NStevenU/MBP-15-A1398-Speaker-Mod/Enclosure/R2.stl

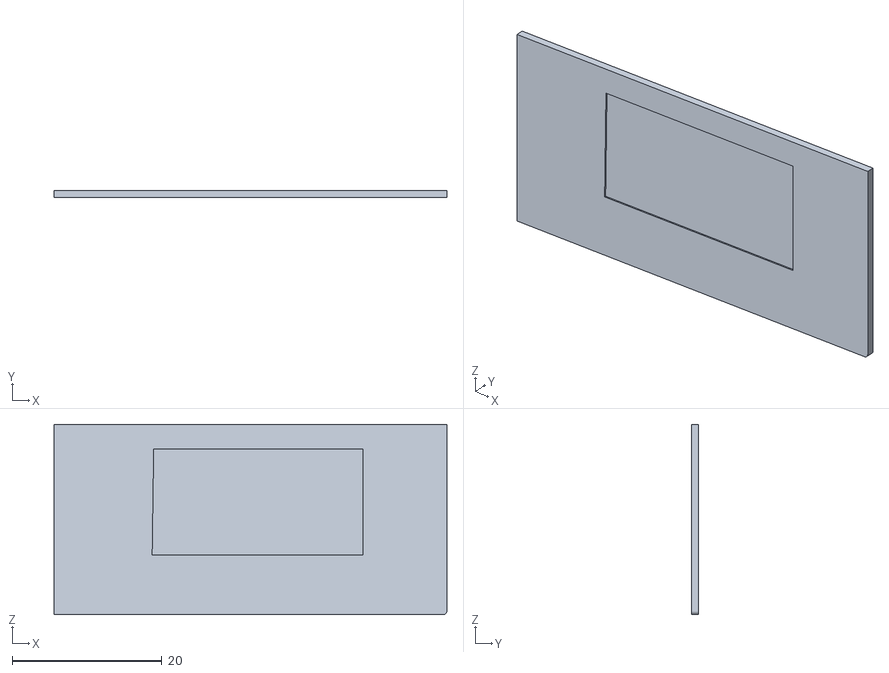
[picture p11: CAD file, 2026-10-30]
Enclosure/R2.stl
52.5 x 1.00 x 25.4
