NStevenU/MBP-15-A1398-Speaker-Mod/Enclosure/R3.stl

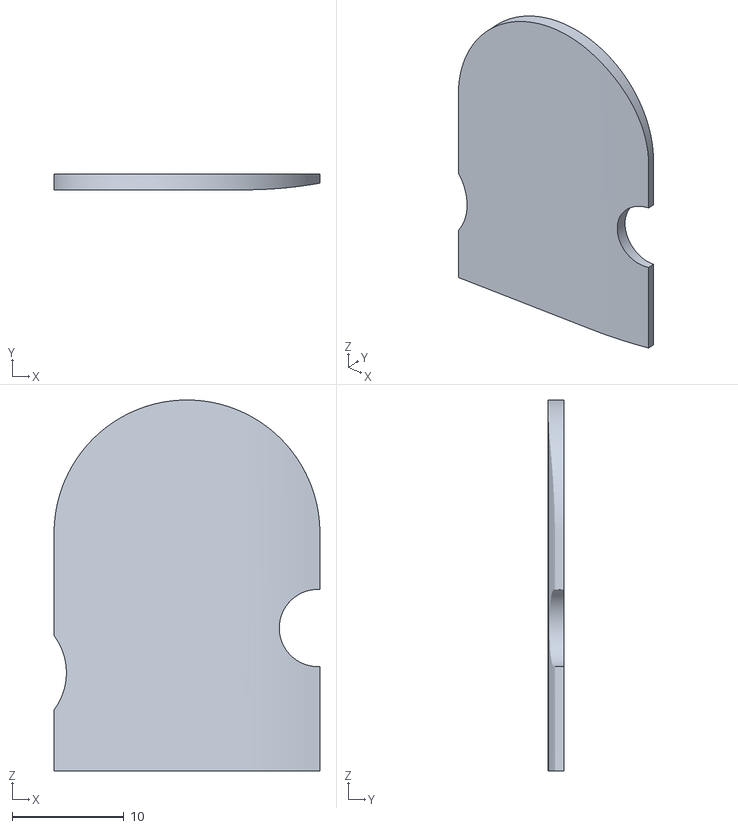
[picture p12: CAD file, 2026-10-30]
Enclosure/R3.stl
23.8 x 1.40 x 33.2
