NStevenU/MBP-15-A1398-Speaker-Mod/Enclosure/Enclosure.step

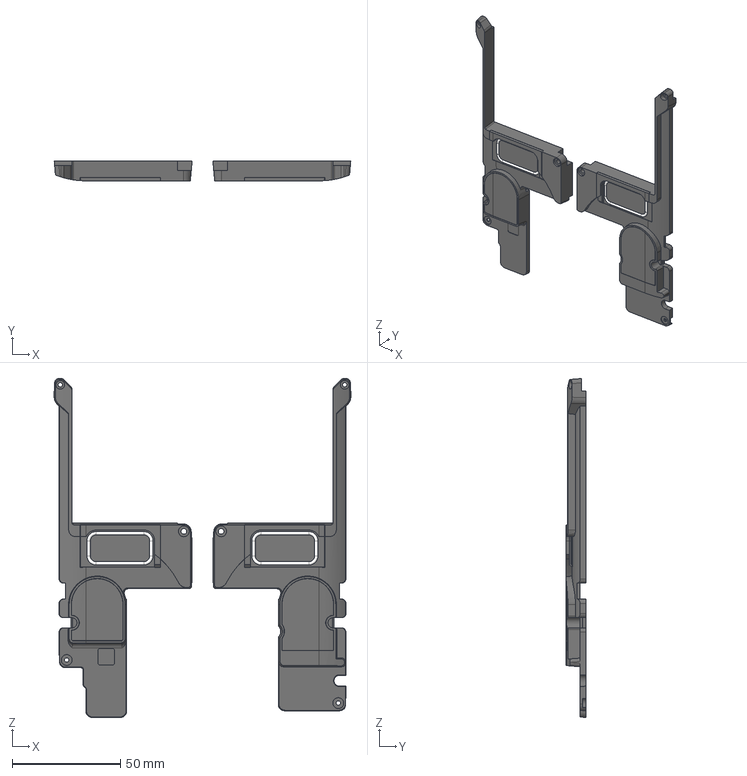
[picture p13: CAD file, 2026-10-30]
Enclosure/Enclosure.step
137.0 x 9.10 x 156.6 mm
Right
Left
