NStevenU/MBP-15-A1398-Speaker-Mod/Enclosure/L4.stl

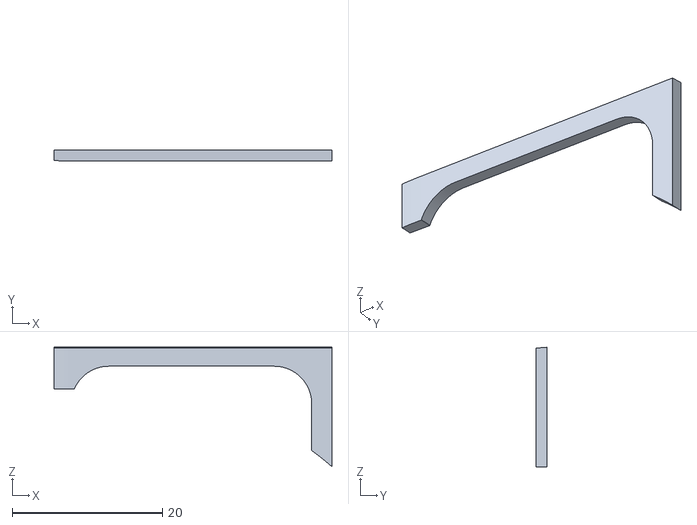
[picture p14: CAD file, 2026-10-30]
Enclosure/L4.stl
37.0 x 1.50 x 15.9
