NStevenU/MBP-15-A1398-Speaker-Mod/Enclosure/R1.stl

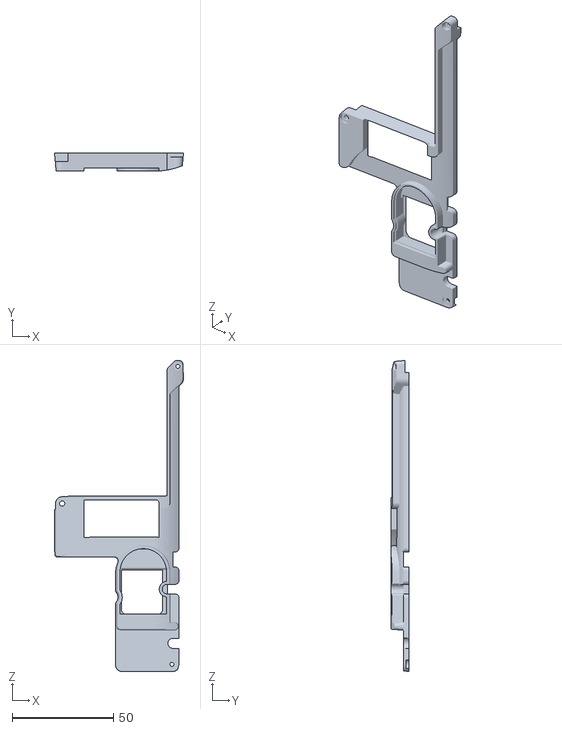
[picture p15: CAD file, 2026-10-30]
Enclosure/R1.stl
63.7 x 9.10 x 153.5
