NStevenU/MBP-15-A1398-Speaker-Mod/Enclosure/L1.stl

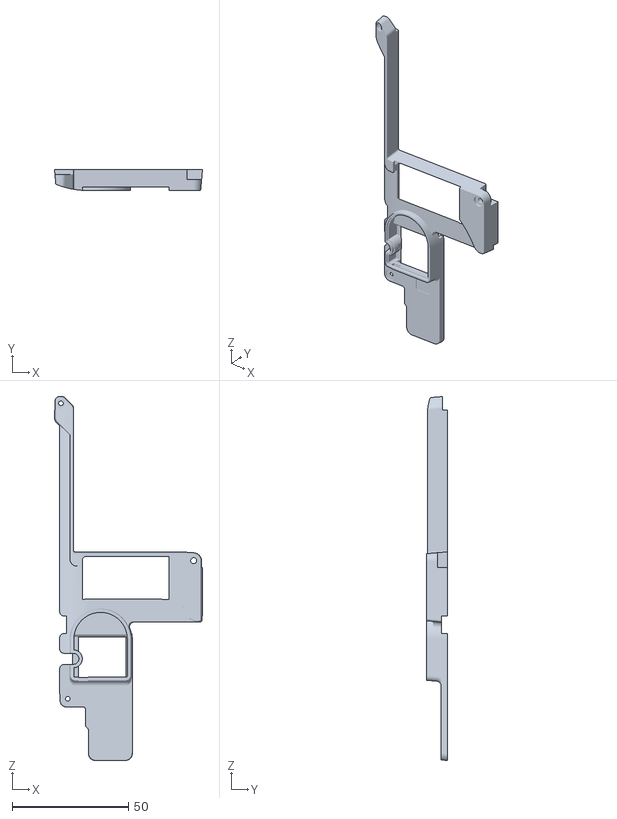
[picture p16: CAD file, 2026-10-30]
Enclosure/L1.stl
63.7 x 9.10 x 156.6
