NStevenU/MBP-15-A1398-Speaker-Mod/Enclosure/L3.stl

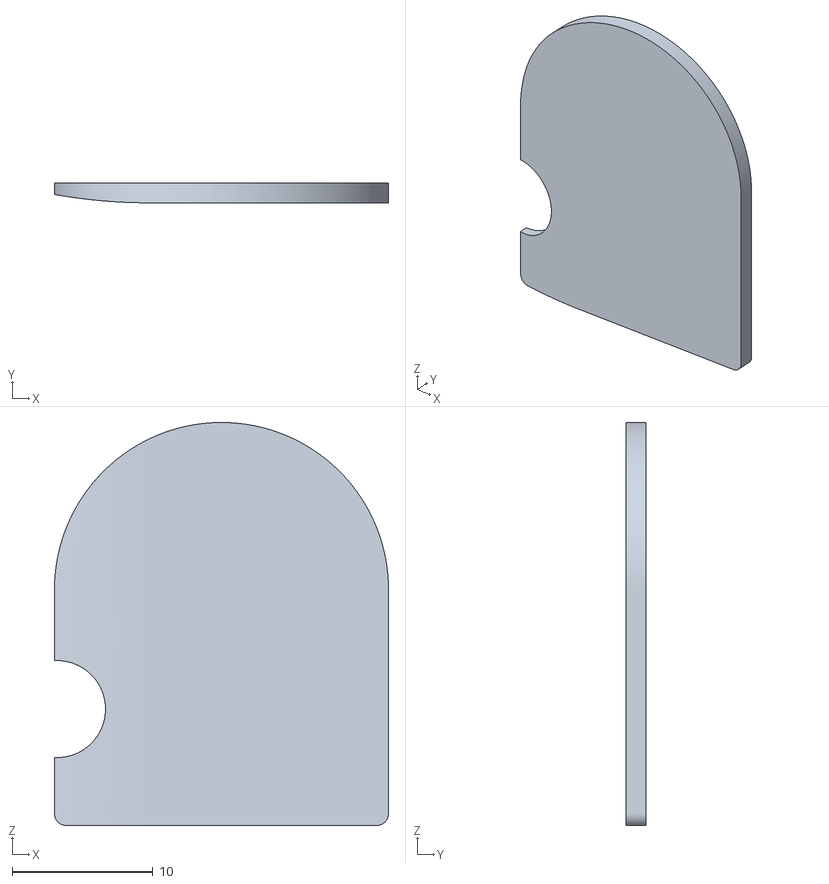
[picture p17: CAD file, 2026-10-30]
Enclosure/L3.stl
23.8 x 1.40 x 28.7
