NStevenU/MBP-15-A1398-Speaker-Mod/(list of files, cad)

Other CAD files:
Enclosure/R4.stl
Enclosure/L2.stl
