NStevenU/MBP-15-A1398-Speaker-Mod/(notices)

Notices in the files:
AppleALC-A1398-Tuned/alc-verb/main.c:
under the terms of the GNU General Public License as published by the
Free Software Foundation; either version 2 of the License, or (at your
